SengerM/UZH_4DPixChip_test_setup/README.md

# UZH 4D Pixel Chip test setup

This repo contains the files for the production of the PCBs for testing 
the analog front end for the 4D pixel readout chip prototype.

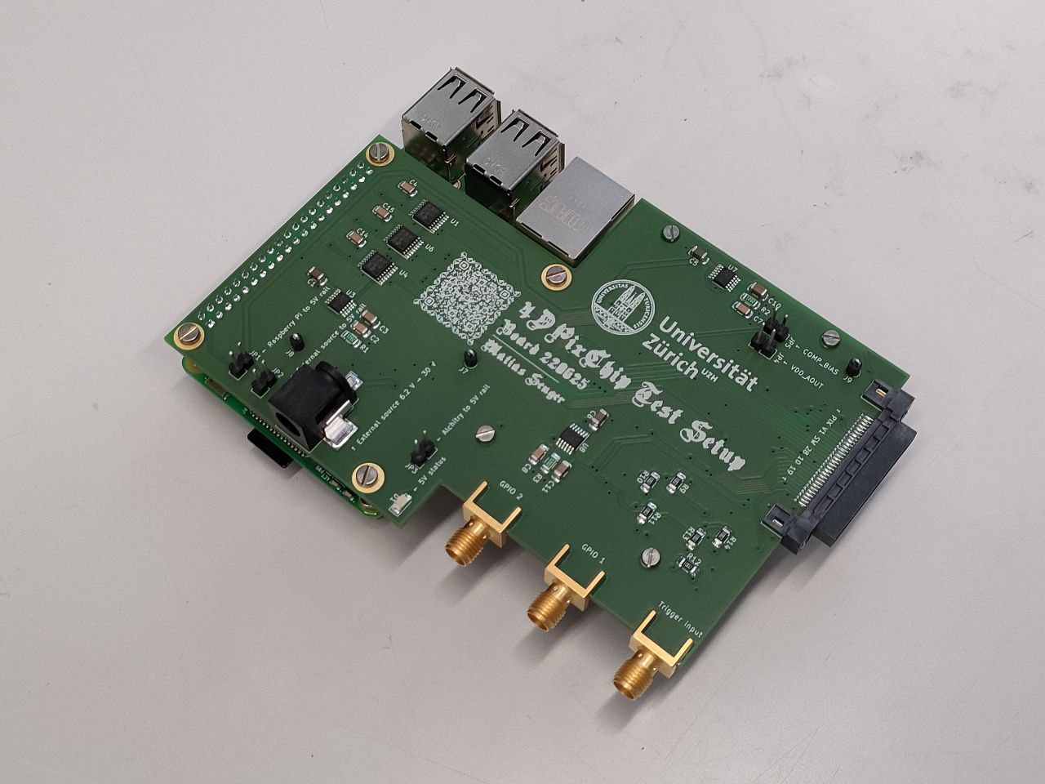
[picture p1: photo_2022-11-09_15-54-43.jpg]
Picture of the boards from the top


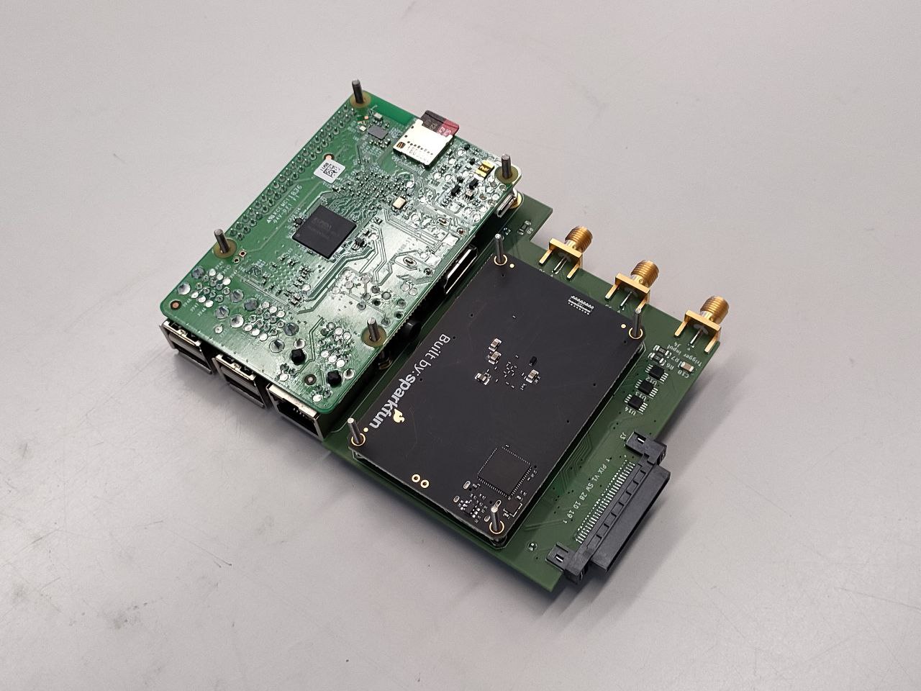
[picture p2: photo_2022-11-09_15-54-36.jpg]
Picture of the boards from the bottom


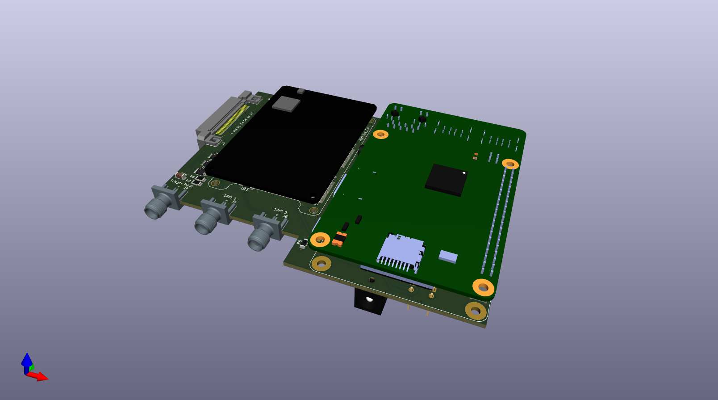
[picture p3: PCB_3D_1.png]


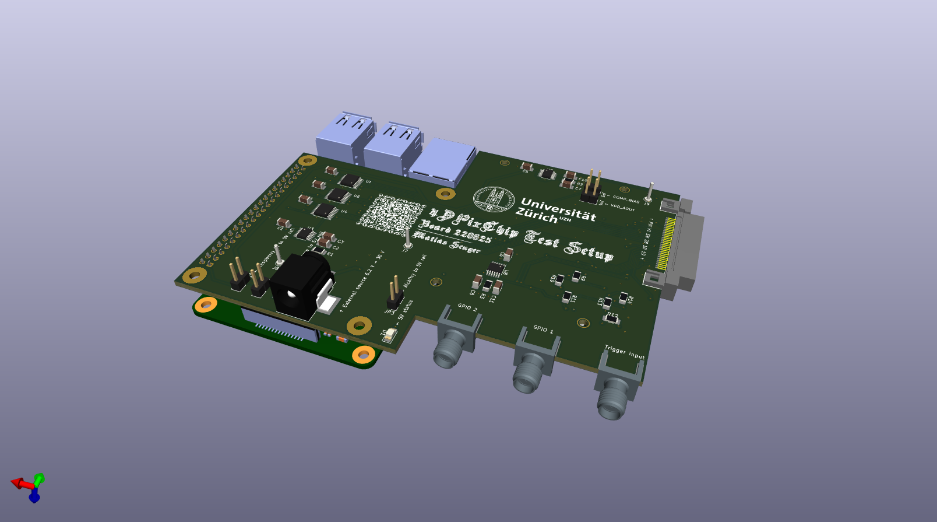
[picture p4: PCB_3D_2.png]
