SengerM/UZH_4DPixChip_test_setup/3D/CUI_DEVICES_PJ-036BH-SMT-TR.step

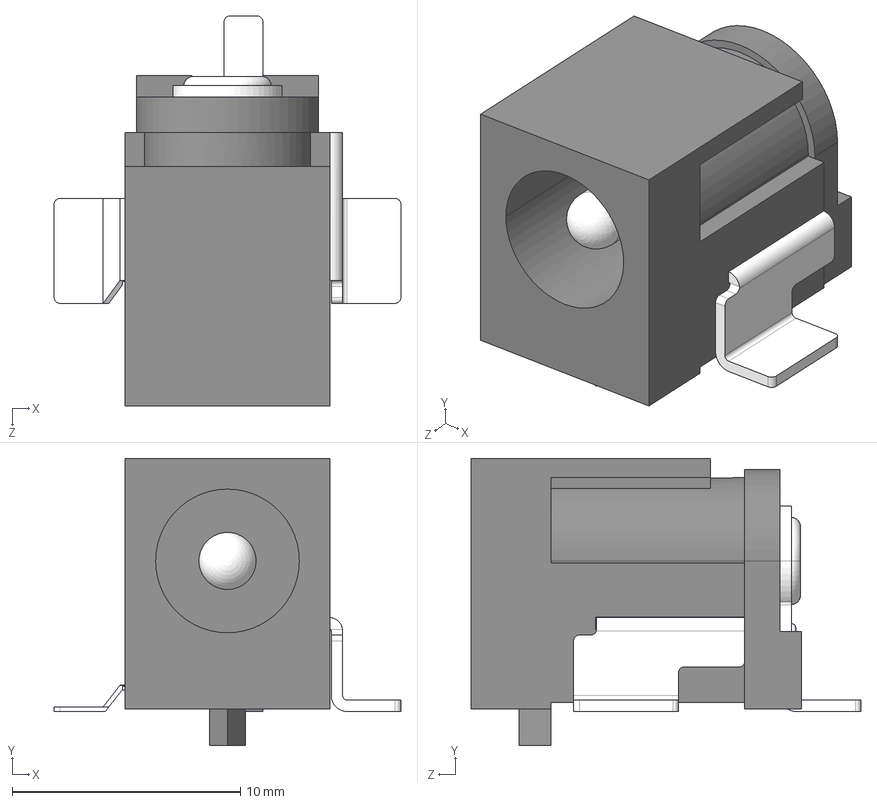
[picture p5: CAD file, 2022-06-25]
3D/CUI_DEVICES_PJ-036BH-SMT-TR.step
15.2 x 12.6 x 17.1 mm
