SengerM/UZH_4DPixChip_test_setup/Alchitry/Alchitry Cu.iges

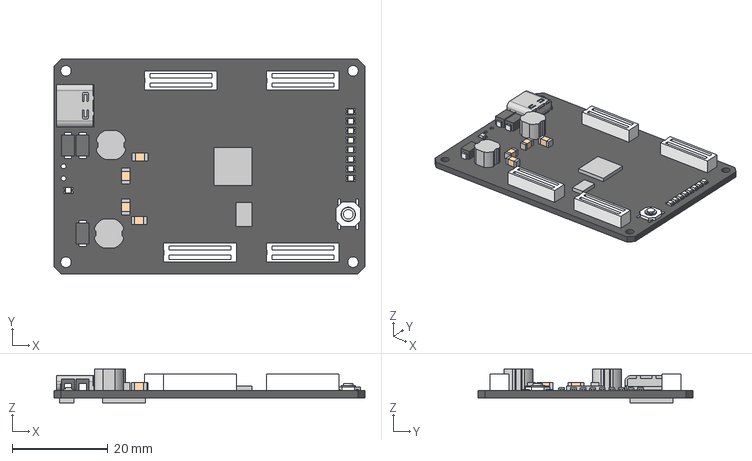
[picture p6: CAD file, 2022-06-25]
Alchitry/Alchitry Cu.iges
65.0 x 45.0 x 7.07 mm
