SengerM/UZH_4DPixChip_test_setup/Raspberry_Pi/2-215307-0--3DModel-STEP-1.STEP

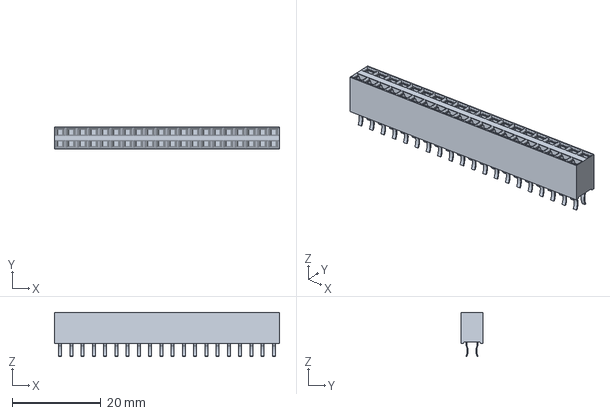
[picture p7: CAD file, 2022-06-23]
Raspberry_Pi/2-215307-0--3DModel-STEP-1.STEP
50.8 x 5.06 x 10.0 mm
