SengerM/UZH_4DPixChip_test_setup/3D/142-0701-801.stp

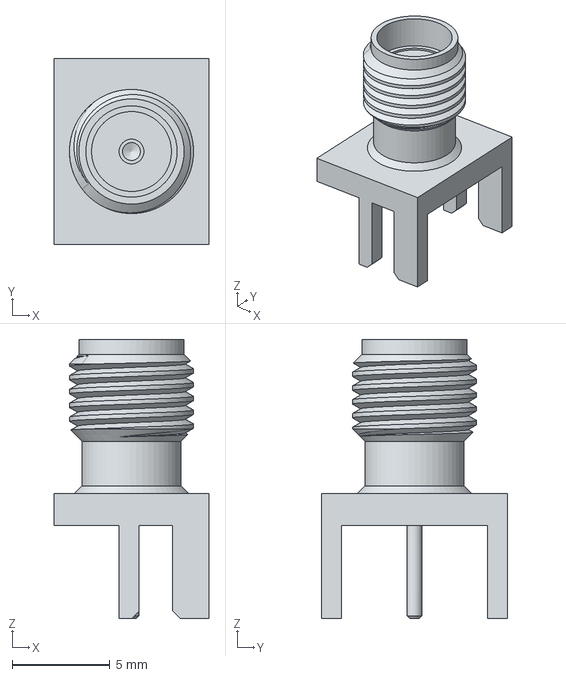
[picture p8: CAD file, 2022-06-25]
3D/142-0701-801.stp
7.92 x 9.53 x 14.3 mm
