SengerM/UZH_4DPixChip_test_setup/UZH_4DPixChip_test_setup.pdf

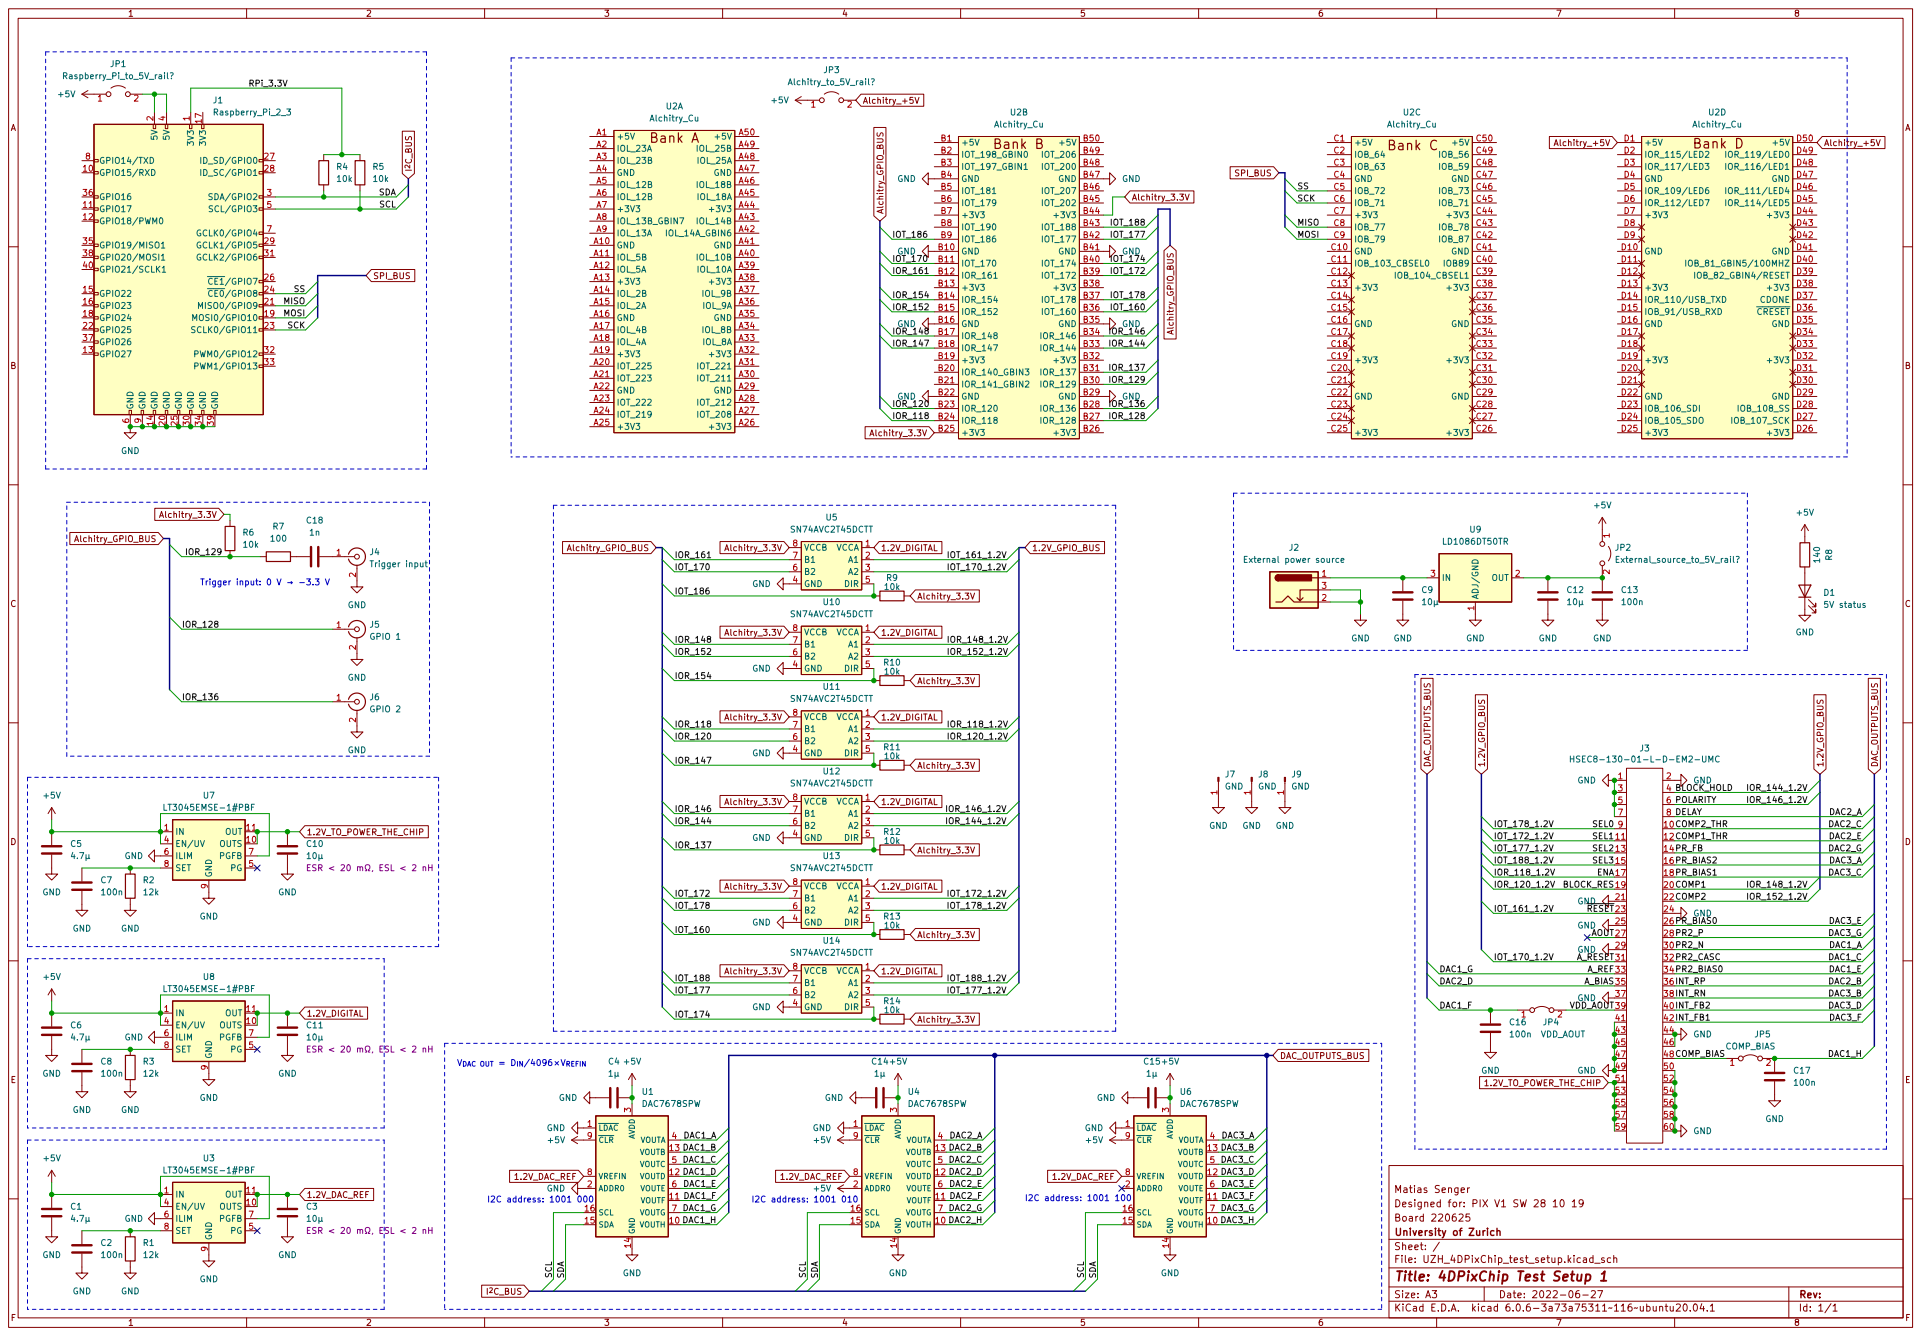
[picture p9: page 1]

3 VOUTA 4 VOUTC 5 VOUTE 6 VOUTG 7 VREFIN 8

Matias Senger
File: UZH_4DPixChip_test_setup.kicad_sch Sheet: / University of Zurich Board 220625 Designed for: PIX V1 SW 28 10 19

Id: 1/1 Title: 4DPixChip Test Setup 1
