SengerM/UZH_4DPixChip_test_setup/(commit log)

2022-06-27 Board finished, still not produced
    [UZH_4DPixChip_test_setup.kicad_pcb, UZH_4DPixChip_test_setup.kicad_sch]
2022-06-27 Added author and date to the pages
    [UZH_4DPixChip_test_setup.kicad_pcb, UZH_4DPixChip_test_setup.kicad_sch]
2022-06-27 Added reference to the `PIX V1 SW 28 10 19` test structure
    [UZH_4DPixChip_test_setup.kicad_pcb, UZH_4DPixChip_test_setup.kicad_sch]
2022-07-04 Added 3D view and schematic PDF
